NickBorodulin/zigbee-co2-monitor/THIRD_PARTY_NOTICES.md

# Third-Party Notices

This project includes or derives some display assets from third-party works. These works retain their own licenses; the repository's top-level license does not replace them.

## Poetsen One

- Font: `PoetsenOne-Regular.ttf`
- The antialiased glyph assets generated from this font (including the `large_*.bin`, `small_*.bin`, and other font glyph files in `display_fs/`) are derived font assets.
- License: SIL Open Font License 1.1 (OFL-1.1).
- Upstream: [Poetsen One on Google Fonts](https://fonts.google.com/specimen/Poetsen+One)
- License text: [SIL Open Font License 1.1](https://openfontlicense.org/open-font-license-official-text/)

The font and derived font assets must be distributed under the OFL. Include the complete OFL 1.1 text with redistributed copies; do not sell the font by itself. The font's copyright and reserved-name information, if present in the supplied font's metadata/license, must be preserved.

## Material Design Icons

- Icon artwork used for the display (including the CO2 molecule artwork and any Material Design Icons-derived thermometer, water, and Wi-Fi assets) is based on the Material Design Icons project by Pictogrammers.
- License: Apache License 2.0.
- Upstream project and license information: [Pictogrammers Material Design Icons](https://github.com/Templarian/MaterialDesign)
- License text: [Apache License 2.0](https://www.apache.org/licenses/LICENSE-2.0)

Include the complete Apache License 2.0 text with redistributed copies of these icons and retain applicable copyright, patent, trademark, and attribution notices supplied by the upstream project.

## Project license

The project's own source code may be distributed under the repository's selected license (for example, MIT). That license does not change the separate OFL-1.1 and Apache-2.0 terms above.
