NickBorodulin/zigbee-co2-monitor/main/OTA_README_RU.md

# Zigbee OTA и настройки датчиков

В этом руководстве описаны выбор единиц температуры, калибровка температуры и влажности, сущности Home Assistant и выпуск Zigbee OTA-обновлений через Zigbee2MQTT (Z2M).

## Единицы температуры и калибровка

Параметр `Temperature unit` в Z2M по умолчанию установлен в `celsius` и задаёт единицы на дисплее. Пороговые значения цветов на дисплее пересчитываются при выборе Фаренгейтов. В Home Assistant передаются отдельные MQTT-поля с фиксированными единицами °C и °F; выбор единиц дисплея на них не влияет.

Конвертер также публикует два отдельных MQTT-поля:

| Поле | Единицы |
| --- | --- |
| `temperature_celsius` | Значение в °C |
| `temperature_fahrenheit` | Значение в °F; Home Assistant сохраняет °F |

Для карточки Home Assistant с нужными единицами укажите `sensor.co2_temperature_celsius` или `sensor.co2_temperature_fahrenheit`. У обеих сущностей намеренно не задан класс Home Assistant `temperature`, поэтому HA не переводит их значения в предпочитаемые системные единицы. Оба значения соответствуют одному измерению: например, 26,5 °C — примерно 79,7 °F.

Абсолютная поправка температуры задаётся от −5 до +5 °C с шагом 0,1 °C. Поправка влажности задаётся от −30 до +30 процентных пунктов с шагом 1. Начальные значения обеих поправок равны нулю. Они сохраняются в NVS после перезапуска и учитываются на дисплее и в показаниях Zigbee. Температурная поправка всегда задаётся в градусах Цельсия, даже если экран показывает Фаренгейты.

Для шкалы температуры в Фаренгейтах указывайте границы и цветовые пороги также в °F. Порогам дисплея соответствуют 64,4 °F (18 °C) и 78,8 °F (26 °C).

## Версии OTA

- `zcl_version` — версия Zigbee Cluster Library. Оставьте значение SDK; это не номер выпуска прошивки.
- `FW_APPLICATION_VERSION` — атрибут `ApplicationVersion` кластера Basic.
- `OTA_FILE_VERSION` — 32-битная версия OTA-прошивки. В текущем исходнике репозитория указано `0x00010005`.
- `OTA_MANUFACTURER_CODE` (`0x1234`) и `OTA_IMAGE_TYPE` (`0x5678`) должны совпадать в прошивке, `.ota`-файле и `index.json`.

Для каждого нового OTA-выпуска увеличивайте `OTA_FILE_VERSION`, собирайте прошивку и передавайте упаковщику ту же версию. Она должна быть выше версии, установленной на устройстве. Не используйте одну версию для разных образов.

## Первая прошивка и ограничения OTA

Таблица разделов содержит `otadata` и два слота приложения по 1344 КиБ (`ota_0` и `ota_1`). Таблицу разделов и первую OTA-совместимую прошивку нужно записать по USB. OTA обновляет только приложение: загрузчик, таблицу разделов и ресурсы `display_fs` таким способом заменить нельзя. Если меняются шрифты или изображения экрана, образ SPIFFS нужно записать отдельно.

До записи приложения в слот обновления прошивка проверяет производителя, тип образа, версию и заявленный размер по заголовку полученного Zigbee OTA-файла.

## Сборка и упаковка Zigbee OTA-образа

Соберите проект через ESP-IDF или CLion. В примере используется папка сборки CLion; при другом профиле замените путь к бинарному файлу.

```powershell
idf.py build
```

Измените `OTA_FILE_VERSION` в `main/zigbee_CO2.c` на номер следующего выпуска и упакуйте именно эту сборку. Пример создаёт версию `0x00010005` в папке `OTA` и прописывает ссылку GitHub Raw:

```powershell
python .\main\make_zigbee_ota.py .\cmake-build-debug\zigbee_CO2.bin --version 0x00010005 --output-dir .\OTA --url-prefix "https://raw.githubusercontent.com/NickBorodulin/zigbee-co2-monitor/main/OTA"
```

Скрипт создаст `OTA/co2-00010005.ota` и обновит `OTA/index.json`. Проверьте, что версия в прошивке, параметр упаковщика, заголовок OTA, версия в индексе, размер и URL соответствуют одному выпуску. Отправьте в GitHub и `.ota`-файл, и `index.json`.

## Настройка Zigbee2MQTT

Есть два способа подключить индекс к Z2M:

1. **Локальный индекс:** разместите файлы OTA в каталоге, доступном контейнеру Z2M, и добавьте `zigbee_ota_override_index_location` в существующий верхнеуровневый блок `ota:` файла `configuration.yaml`:

   ```yaml
   ota:
     zigbee_ota_override_index_location: "OTA/index.json"
   ```

   Путь задаётся относительно каталога данных Z2M, где находится `configuration.yaml`. Если блок `ota:` уже существует, добавьте строку внутрь него, не создавая второй блок. После изменения перезапустите Z2M.

2. **Индекс GitHub Raw:** в настройках OTA устройства выберите пользовательский источник индекса и укажите:

   ```text
   https://raw.githubusercontent.com/NickBorodulin/zigbee-co2-monitor/main/OTA/index.json
   ```

После выбора источника снова запустите проверку OTA. Образ будет предложен только при совпадении производителя, типа образа и версии с требованиями устройства.

## Запуск обновления

В интерфейсе Z2M откройте устройство CO2, проверьте наличие обновления и запустите установку. То же можно сделать через MQTT. При необходимости замените `CO2` на сетевое имя устройства или его IEEE-адрес.

Проверка обновления:

```text
Тема:    zigbee2mqtt/bridge/request/device/ota_update/check
Данные:  {"id":"CO2","url":"https://raw.githubusercontent.com/NickBorodulin/zigbee-co2-monitor/main/OTA/index.json"}
```

Запуск после того, как Z2M подтвердит доступность более новой версии:

```text
Тема:    zigbee2mqtt/bridge/request/device/ota_update/update
Данные:  {"id":"CO2"}
```

Не отключайте питание, пока Z2M не сообщит о завершении и устройство не перезагрузится. После перезапуска проверьте версию прошивки и новые показания. Обычно повторное сопряжение не требуется: Zigbee-данные хранятся в отдельном разделе.

## Диагностика и ограничения

- **Образ не найден:** проверьте совпадение `OTA_FILE_VERSION`, параметра `--version` и `fileVersion` в `index.json`; версия должна быть выше установленной.
- **Ошибка индекса или скачивания:** откройте URL индекса и URL `.ota` из него. Убедитесь, что файлы отправлены в ту же ветку и каталог GitHub.
- **Устройство отклоняет образ:** проверьте последовательный лог на ошибки производителя, типа образа, версии и OTA-заголовка. Идентификаторы должны быть `0x1234` и `0x5678`, а версия — выше версии работающей прошивки.
- **Тайм-аут загрузки:** оставьте устройство включённым и расположите его ближе к Zigbee-сети. Тайм-аут означает, что передача не завершилась; последовательный лог поможет выяснить, отклонило ли устройство образ или перестало принимать блоки.

Перед использованием OTA без присмотра проверьте обновление на целевом устройстве. Этот механизм не обновляет загрузчик, таблицу разделов и файловую систему дисплея.
