NickBorodulin/zigbee-co2-monitor/hardware/Schematic_Zegbee-CO2_2026-10-31.png

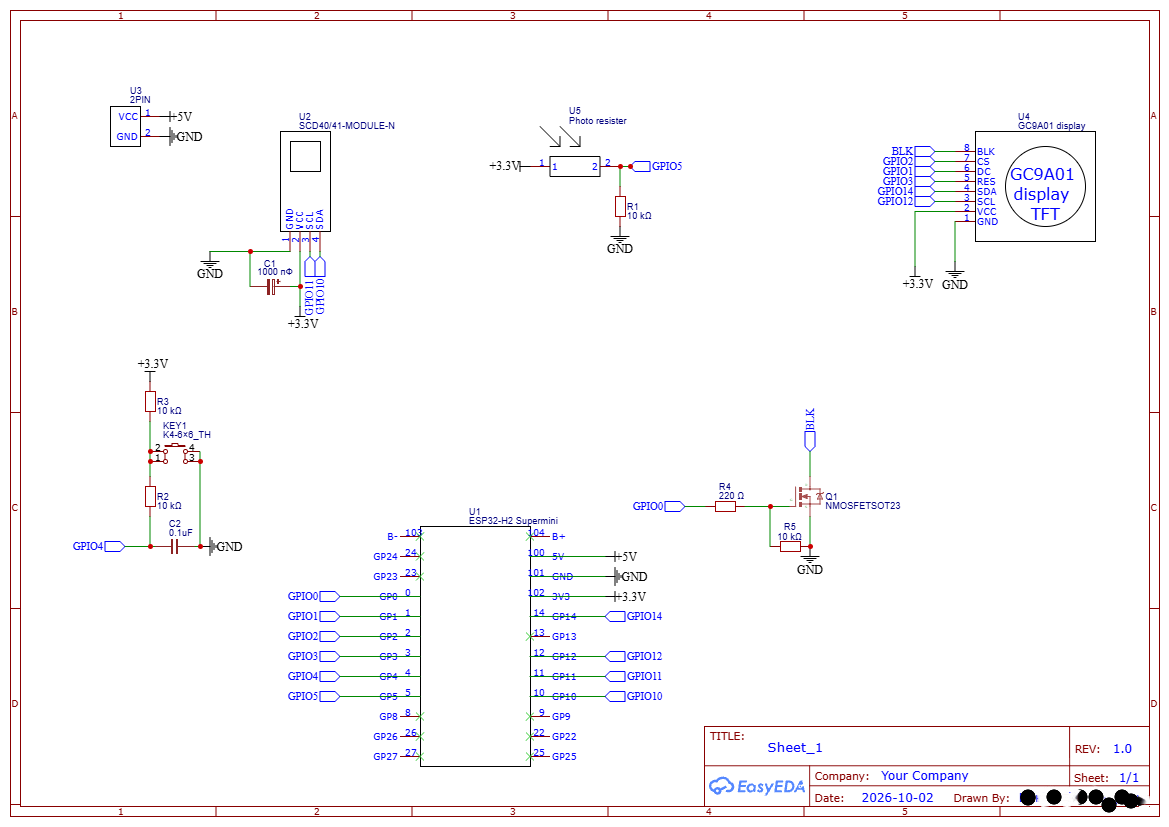
hardware/Schematic_Zegbee-CO2_2026-10-31.png
