NickBorodulin/zigbee-co2-monitor/hardware/3D Print/BOX_004.stl

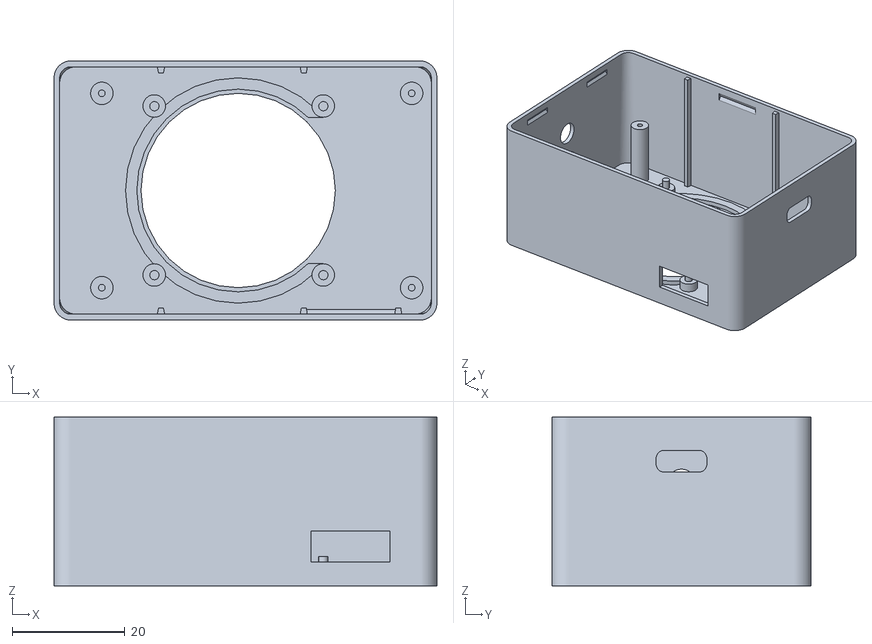
[picture p4: CAD file, 2026-11-07]
hardware/3D Print/BOX_004.stl
68.0 x 46.0 x 30.0
