NickBorodulin/zigbee-co2-monitor/hardware/3D Print/BOX_top_004.stl

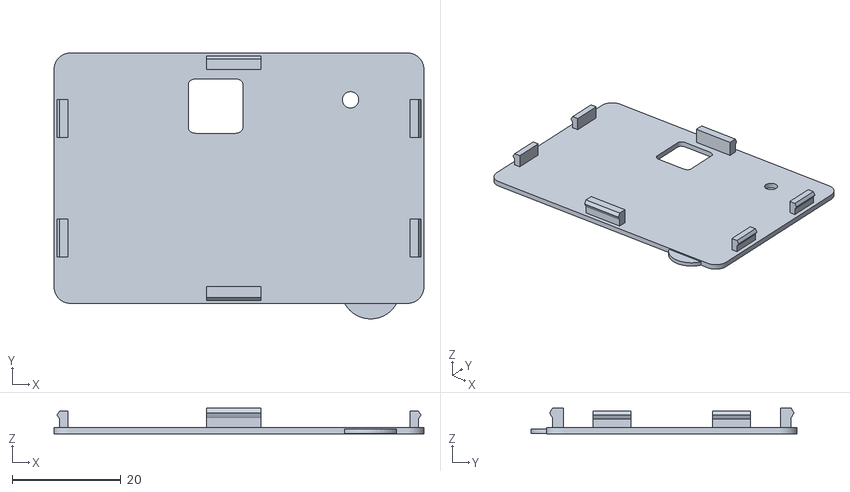
[picture p5: CAD file, 2026-11-07]
hardware/3D Print/BOX_top_004.stl
68.0 x 48.9 x 4.70
