NickBorodulin/zigbee-co2-monitor/main/poetsen_digits.h

// Generated from Poetsen One Regular; 4-bit grayscale masks, 92 px source size.
// Typeface by Pablo Impallari and Rodrigo Fuenzalida; SIL Open Font License 1.1.
// License: https://openfontlicense.org/
#ifndef POETSEN_DIGITS_H
#define POETSEN_DIGITS_H
#include <stdint.h>
#define POETSEN_DIGIT_HEIGHT 68
typedef struct { uint8_t width; const uint8_t *coverage; } poetsen_glyph_t;
static const uint8_t poetsen_digit_0[1836] = {
    0x00,    0x00,    0x00,    0x00,    0x00,    0x00,    0x00,    0x00,
    0x00,    0x00,    0x00,    0x14,    0x69,    0xAD,    0xFF,    0xFF,
    0xFF,    0xA9,    0x63,    0x10,    0x00,    0x00,    0x00,    0x00,
    0x00,    0x00,    0x00,    0x00,    0x00,    0x00,    0x00,    0x00,
    0x00,    0x00,    0x00,    0x00,    0x02,    0x7D,    0xFF,    0xFF,
    0xFF,    0xFF,    0xFF,    0xFF,    0xFF,    0xFF,    0xF9,    0x50,
    0x00,    0x00,    0x00,    0x00,    0x00,    0x00,    0x00,    0x00,
    0x00,    0x00,    0x00,    0x00,    0x00,    0x00,    0x05,    0xDF,
    0xFF,    0xFF,    0xFF,    0xFF,    0xFF,    0xFF,    0xFF,    0xFF,
    0xFF,    0xFF,    0xFD,    0x50,    0x00,    0x00,    0x00,    0x00,
    0x00,    0x00,    0x00,    0x00,    0x00,    0x00,    0x00,    0x00,
    0x05,    0xDF,    0xFF,    0xFF,    0xFF,    0xFF,    0xFF,    0xFF,
    0xFF,    0xFF,    0xFF,    0xFF,    0xFF,    0xFF,    0xFA,    0x10,
    0x00,    0x00,    0x00,    0x00,    0x00,    0x00,    0x00,    0x00,
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
    0x10,    0x00,    0x00,    0x00,    0x09,    0xFF,    0xFF,    0xFF,
    0xFF,    0xFF,    0xFF,    0xFF,    0xFF,    0xFF,    0xFF,    0xFF,
    0xFF,    0xFF,    0xFF,    0xFF,    0xFF,    0xFF,    0xFF,    0xFF,
    0xFF,    0x60,    0x00,    0x00,    0x00,    0x4F,    0xFF,    0xFF,
    0xFF,    0xFF,    0xFF,    0xFF,    0xFF,    0xFF,    0xFF,    0xFF,
    0xFF,    0xFF,    0xFF,    0xFF,    0xFF,    0xFF,    0xFF,    0xFF,
    0xFF,    0xFF,    0xF1,    0x00,    0x00,    0x00,    0xDF,    0xFF,
    0xFF,    0xFF,    0xFF,    0xFF,    0xFF,    0xFF,    0xFF,    0xFF,
    0xFF,    0xFF,    0xFF,    0xFF,    0xFF,    0xFF,    0xFF,    0xFF,
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
};
static const poetsen_glyph_t poetsen_digits[10] = {
    { 54, poetsen_digit_0 },
    { 29, poetsen_digit_1 },
    { 49, poetsen_digit_2 },
    { 47, poetsen_digit_3 },
    { 50, poetsen_digit_4 },
    { 48, poetsen_digit_5 },
    { 50, poetsen_digit_6 },
    { 44, poetsen_digit_7 },
    { 49, poetsen_digit_8 },
    { 50, poetsen_digit_9 },
};
#endif
