NickBorodulin/zigbee-co2-monitor/main/poetsen_small_assets.h

// Precomputed small Poetsen masks; no runtime glyph scaling.

#ifndef POETSEN_SMALL_ASSETS_H

#define POETSEN_SMALL_ASSETS_H

#include <stdint.h>

#define POETSEN_SMALL_HEIGHT 14

typedef struct { uint8_t width; const uint8_t *coverage; } poetsen_small_glyph_t;

static const uint8_t poetsen_small_digit_0[77] = {
    0x00, 0x00, 0x06, 0xFA, 0x00, 0x00, 0x00, 0xAF, 0xFF, 0xFF, 0xF0, 0x00, 0xFF, 0xFF, 0xFF, 0xFF,
    0x30, 0x1F, 0xFF, 0xF0, 0xFF, 0xFF, 0x0F, 0xFF, 0xF0, 0x01, 0xFF, 0xF0, 0xFF, 0xF0, 0x00, 0x0F,
    0xFF, 0x6F, 0xFF, 0x00, 0x00, 0xFF, 0xFF, 0xFF, 0xF0, 0x00, 0x0F, 0xFF, 0xFF, 0xFF, 0x00, 0x00,
    0xFF, 0xFB, 0xFF, 0xF0, 0x00, 0xAF, 0xFF, 0x3F, 0xFF, 0x00, 0x0F, 0xFF, 0xF0, 0xFF, 0xFF, 0x0F,
    0xFF, 0xF0, 0x0A, 0xFF, 0xFF, 0xFF, 0xF8, 0x00, 0x0F, 0xFF, 0xFF, 0xF4, 0x00
};

static const uint8_t poetsen_small_digit_1[42] = {
    0x00, 0x00, 0x00, 0x00, 0xFF, 0xFF, 0x2F, 0xFF, 0xFF, 0x0F, 0xFF, 0xFF, 0x00, 0x1F, 0xFF, 0x00,
    0x0F, 0xFF, 0x00, 0x0F, 0xFF, 0x00, 0x0F, 0xFF, 0x00, 0x0F, 0xFF, 0x00, 0x0F, 0xFF, 0x00, 0x6F,
    0xFF, 0x00, 0xAF, 0xFF, 0x00, 0xFF, 0xFF, 0x00, 0x0F, 0xFF
};

static const uint8_t poetsen_small_digit_2[70] = {
    0x00, 0x00, 0x1F, 0xF4, 0x00, 0x00, 0x0F, 0xFF, 0xFF, 0xF0, 0x00, 0xFF, 0xFF, 0xFF, 0xFF, 0x0F,
    0xFF, 0xF0, 0xFF, 0xFF, 0x0F, 0xFF, 0x00, 0x0F, 0xFF, 0x00, 0xFF, 0x00, 0x1F, 0xFF, 0x00, 0x00,
    0x00, 0xFF, 0xFF, 0x00, 0x00, 0x0F, 0xFF, 0xF0, 0x00, 0x00, 0xFF, 0xFF, 0x20, 0x00, 0x0F, 0xFF,
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
    0x8F, 0xF0, 0x00, 0x00, 0x00, 0x00, 0x00, 0x00, 0x00, 0x00, 0x00, 0x8F, 0xD0, 0x00, 0x00, 0x08,
    0xFD, 0x00, 0x00, 0x00, 0x00, 0x00, 0x00, 0x00, 0x00, 0x00, 0x01, 0xDC, 0x00, 0x00, 0x00, 0x1D,
    0xC0, 0x00, 0x00, 0x00, 0x00, 0x00, 0x00, 0x00, 0x00, 0x00
};

#endif
