NickBorodulin/zigbee-co2-monitor/(commit log)

2026-10-30 Add ESP32-H2 Zigbee CO2 monitor firmware
    [partitions.csv]
2026-10-30 Add PCB Gerber files
2026-10-30 Add project documentation and hardware schematic
2026-11-05 Add sensor calibration controls and entity icons
2026-11-07 Improve temperature units and OTA update handling
    - Extend temperature calibration range to ±5 °C
    - Fix Celsius and Fahrenheit values exposed to Home Assistant
    - Validate OTA image metadata from the received file
    [zigbee_CO2.c]
2026-11-07 Add 3D-printable enclosure models and previews
    - Add STL files for the enclosure and top cover
    - Add multi-angle JPG previews
    - Document the 3D-printable parts in English and Russian READMEs
    [BOX_004.stl, BOX_top_004.stl]
2026-11-08 Fix Zigbee OTA handling and prevent sensor loop stalls
    - Parse OTA metadata from the Zigbee callback header and process the received image stream correctly
    - Use a bounded Zigbee lock wait when reporting sensor values
    - Refresh the v1.0.4 OTA image, index, and bilingual documentation
    [zigbee_CO2.c]
2026-11-09 Improve Zigbee link recovery and temperature entities
    Keep sensor reporting active when the Zigbee neighbor table has no active links, and remove the redundant dynamic temperature entity while retaining the Celsius and Fahrenheit sensors.
2026-11-09 Fix OTA image stream size validation
    [zigbee_CO2.c]
